chili023/uaefi2stroke/moto/uaefi-moto-pinout.xlsx

Sheet: Anleitung
uaEFI moto – Signal- und Pinbelegung
So bearbeitest du die Belegung:
1. Im Blatt "Signale" nur die gelben Spalten ändern: Stecker (A, B, EGT oder leer), Pin, Kabelfarbe, Querschnitt.
2. Die Blätter "Stecker A", "Stecker B" und "EGT" zeigen automatisch, was auf jedem Pin liegt, inkl. freier und doppelt belegter Pins.
3. Das Blatt "Prüfung" zeigt je Gruppe, ob die Regeln eingehalten sind (rot = Problem).
4. Neue Signale: einfach unten im Blatt "Signale" eine Zeile anhängen (bis Zeile 150 wird alles ausgewertet).
5. Zum Verkabeln die Blätter "Stecker A", "Stecker B" und "EGT" ausdrucken: Pin, Signal, Kabelfarbe, Querschnitt in Pin-Reihenfolge.
Regeln:
• Eine Gruppe (z. B. Lambda 1, alle Einspritzdüsen, VR) liegt komplett auf einem Stecker.
• Versorgung 12V, 5V Sensorversorgung und Sensormasse müssen auf beiden Steckern A und B vorkommen.
• Masse (Leistungsmasse, USB-Masse, VR-Schirm) darf auf beiden liegen.
• Jeder Pin höchstens einmal. Stecker A und B haben je 34 Pins, der EGT-Block 8 (4 Buchsen × 2).
Stecker:
A = TE Superseal 1.0 Header 6437288-1 (Keying 1), Gegenstecker 4-1437290-0
B = TE Superseal 1.0 Header 6437288-2 (Keying 2), Gegenstecker 4-1437290-1
EGT = 4× Omega PCC-SMP-K Mini-Thermoelementbuchse Typ K
Kontakte: alle gleich 1,0 mm, bis 15 A laut TE-Katalog, Kabel 0,5–1,25 mm² (Kontakt 3-1447221-4 bzw. -3)
Quelle Netz/MCU: Netzliste des uaEFI-moto-Schaltplans (chili023/uaefi2stroke, Branch uaefi-moto).
Eingetragen: Stecker A = Basis (alles mit 1: INJ/IGN/GPPWM 1-2, TPS1, CLT, IAT, Hall 1, Lambda 1, USB, CAN), Stecker B = Rest. INJ/IGN 5-6 unbenutzt.
Strom max: Richtwerte (Einspritzdüse/GPPWM-Ausgang bis 3 A, LSU-4.9-Heizung kalt kurz bis 2 A).
Bestückung, die von der uaEFI abweicht:
• Radsensor 2 (B28, PA6): R39 = 4,7k Pull-up auf 5V bestücken, R36 (10k nach Masse) weglassen. Für Hall-Radsensoren; induktive Sensoren gehen dort nicht.
• Radsensor 1 (B20, PE14) hat den 4,7k Pull-up schon.
• Einspritzung/Zündung 5–6 sind auf der Platine vorhanden, aber nicht auf den Steckern.

Sheet: Signale
Gruppe | Signal | Netz (Schaltplan) | MCU / rusEFI | Typ | Strom max | Stecker | Pin | Bemerkung | Schlüssel | Status | Kabelfarbe | Querschnitt mm²
Versorgung 12V | +12V Batterie / ECU-Versorgung | +12V | - | Versorgung | 2 A | A | 1 | über F2 auf +12V_RAW |  |  |  | 0.75
Versorgung 12V | Zündung (Schlüssel) | /12V_KEY | MM100_IN_VBATT (PA5 über Teiler) | Eingang | 0,1 A | A | 2 | ohne Main-Relais identisch mit +12V |  |  |  | 0.50
Versorgung 12V | +12V Hallsensoren (A) | /12V_HALL | - | Versorgung | 0,2 A | A | 3 | PTC F11 200 mA, gleiches Netz wie B1 |  |  |  | 0.75
5V Sensorversorgung | +5V Sensor (A1) | +5VP | - | Versorgung | 0,1 A | A | 4 | geschützte 5V |  |  |  | 0.50
5V Sensorversorgung | +5V Sensor (A2) | +5VP | - | Versorgung | 0,1 A | A | 5 |  |  |  |  | 0.50
Sensormasse | Sensormasse (A1) | GNDA | - | Masse | 0,1 A | A | 6 |  |  |  |  | 0.50
Sensormasse | Sensormasse (A2) | GNDA | - | Masse | 0,1 A | A | 7 |  |  |  |  | 0.50
Masse | Leistungsmasse (A1) | GND | - | Masse | 10 A | A | 8 |  |  |  |  | 0.75
Masse | Leistungsmasse (A2) | GND | - | Masse | 10 A | A | 9 |  |  |  |  | 0.75
Masse | Leistungsmasse (A3) | GND | - | Masse | 10 A | A | 10 |  |  |  |  | 0.75
Einspritzung 1-2 | Einspritzdüse 1 | /OUT_INJ1 | MM100_INJ1 (PD3) | Low-Side | 3 A | A | 11 |  |  |  |  | 0.75
Einspritzung 1-2 | Einspritzdüse 2 | /OUT_INJ2 | MM100_INJ2 (PA9) | Low-Side | 3 A | A | 12 |  |  |  |  | 0.75
Einspritzung 3-4 | Einspritzdüse 3 | /OUT_INJ3 | MM100_INJ3 (PD11) | Low-Side | 3 A | B | 5 |  |  |  |  | 0.75
Einspritzung 3-4 | Einspritzdüse 4 | /OUT_INJ4 | MM100_INJ4 (PD10) | Low-Side | 3 A | B | 6 |  |  |  |  | 0.75
Einspritzung 5-6 (unbenutzt) | Einspritzdüse 5 | /OUT_INJ5 | MM100_INJ5 (PD2) | Low-Side | 3 A
Einspritzung 5-6 (unbenutzt) | Einspritzdüse 6 | /OUT_INJ6 | MM100_INJ6 (PA8) | Low-Side | 3 A
Zündung 1-2 | Zündspule 1 | /OUT_IGN1 | MM100_IGN1 (PC13) | Logik 5V | 0,02 A | A | 13 | für Spulen mit eingebauter Endstufe |  |  |  | 0.50
Zündung 1-2 | Zündspule 2 | /OUT_IGN2 | MM100_IGN2 (PE5) | Logik 5V | 0,02 A | A | 14 | für Spulen mit eingebauter Endstufe |  |  |  | 0.50
Zündung 3-4 | Zündspule 3 | /OUT_IGN3 | MM100_IGN3 (PE4) | Logik 5V | 0,02 A | B | 7 | für Spulen mit eingebauter Endstufe |  |  |  | 0.50
Zündung 3-4 | Zündspule 4 | /OUT_IGN4 | MM100_IGN4 (PE3) | Logik 5V | 0,02 A | B | 8 | für Spulen mit eingebauter Endstufe |  |  |  | 0.50
Zündung 5-6 (unbenutzt) | Zündspule 5 | /OUT_IGN5 | MM100_IGN5 (PE2) | Logik 5V | 0,02 A |  |  | für Spulen mit eingebauter Endstufe
Zündung 5-6 (unbenutzt) | Zündspule 6 | /OUT_IGN6 | MM100_IGN6 (PB8) | Logik 5V | 0,02 A |  |  | für Spulen mit eingebauter Endstufe
GPPWM 1-2 | GPPWM1 | /OUT_LS1 | MM100_INJ7 (PD15) | Low-Side | 3 A | A | 15 | mit Freilaufdiode |  |  |  | 0.75
GPPWM 1-2 | GPPWM2 | /OUT_LS2 | MM100_INJ8 (PD12) | Low-Side | 3 A | A | 16 | mit Freilaufdiode |  |  |  | 0.75
GPPWM 3-4 | GPPWM3 | /OUT_LS3 | MM100_OUT_PWM1 (PD13) | Low-Side | 3 A | B | 9 | mit Freilaufdiode |  |  |  | 0.75
GPPWM 3-4 | GPPWM4 | /OUT_LS4 | MM100_OUT_PWM2 (PC6) | Low-Side | 3 A | B | 10 | mit Freilaufdiode |  |  |  | 0.75
Basis-Sensoren | TPS1 | /IN_TPS1 | MM100_IN_TPS (PA4) | Analog 0–5V | - | A | 17 |  |  |  |  | 0.50
Basis-Sensoren | CLT | /IN_CLT | MM100_IN_CLT (PC2) | Analog 0–5V | - | A | 18 |  |  |  |  | 0.50
Basis-Sensoren | IAT | /IN_IAT | MM100_IN_IAT (PC3) | Analog 0–5V | - | A | 19 |  |  |  |  | 0.50
Hall 1 | Hall 1 (Kurbelwelle) | /IN_HALL1 | MM100_IN_D1 (PE12) | Digital | - | A | 20 | 4,7k Pull-up, Trigger in Firmware |  |  |  | 0.50
Lambda 1 | Lambda 1 Heizung + (LSU Pin 4) | +12V_RAW | Modul M5 | Lambda | 2 A | A | 21 | kalt kurz bis 2 A |  |  |  | 0.75
Lambda 1 | Lambda 1 Heizung − (LSU Pin 3) | /3_WBO_Heater | Modul M5 | Lambda | 2 A | A | 22 | kalt kurz bis 2 A |  |  |  | 0.75
Lambda 1 | Lambda 1 Ip (LSU Pin 1) | /1_WBO_Ip | Modul M5 | Lambda | 0,01 A | A | 23 |  |  |  |  | 0.50
Lambda 1 | Lambda 1 Vm (LSU Pin 2) | /2_WBO_Vm | Modul M5 | Lambda | 0,01 A | A | 24 |  |  |  |  | 0.50
Lambda 1 | Lambda 1 Un (LSU Pin 6) | /6_WBO_Un | Modul M5 | Lambda | 0,01 A | A | 25 |  |  |  |  | 0.50
Lambda 1 | Lambda 1 Rtrim (LSU Pin 5) | /5_WBO_Rtrim | Modul M5 | Lambda | 0,01 A | A | 26 |  |  |  |  | 0.50
Lambda 2 | Lambda 2 Heizung + (LSU Pin 4) | +12V_RAW | Modul M8 | Lambda | 2 A | B | 29 | kalt kurz bis 2 A |  |  |  | 0.75
Lambda 2 | Lambda 2 Heizung − (LSU Pin 3) | /WBO2_Heater | Modul M8 | Lambda | 2 A | B | 30 | kalt kurz bis 2 A |  |  |  | 0.75
Lambda 2 | Lambda 2 Ip (LSU Pin 1) | /WBO2_Ip | Modul M8 | Lambda | 0,01 A | B | 31 |  |  |  |  | 0.50
Lambda 2 | Lambda 2 Vm (LSU Pin 2) | /WBO2_Vm | Modul M8 | Lambda | 0,01 A | B | 32 |  |  |  |  | 0.50
Lambda 2 | Lambda 2 Un (LSU Pin 6) | /WBO2_Un | Modul M8 | Lambda | 0,01 A | B | 33 |  |  |  |  | 0.50
Lambda 2 | Lambda 2 Rtrim (LSU Pin 5) | /WBO2_Rtrim | Modul M8 | Lambda | 0,01 A | B | 34 |  |  |  |  | 0.50
USB | USB VBUS | /VBUS | VBUS (N1) | USB | 0,1 A | A | 27 | USB-Erkennung |  |  |  | 0.50
USB | USB D+ | /USB+ | PA12 | USB | - | A | 28 | verdrillt mit D− |  |  |  | 0.50
USB | USB D− | /USB- | PA11 | USB | - | A | 29 |  |  |  |  | 0.50
USB | USB Masse | GND | - | Masse | - | A | 30 |  |  |  |  | 0.50
CAN | CAN High | /CAN+ | CAN-Modul M7 | CAN | - | A | 31 | intern auch Lambda-Module |  |  |  | 0.50
CAN | CAN Low | /CAN- | CAN-Modul M7 | CAN | - | A | 32 |  |  |  |  | 0.50
Versorgung 12V | +12V Hallsensoren (B) | /12V_HALL | - | Versorgung | 0,2 A | B | 1 | gleiches Netz wie A3 |  |  |  | 0.75
5V Sensorversorgung | +5V Sensor (B) | +5VP | - | Versorgung | 0,1 A | B | 2 |  |  |  |  | 0.50
Sensormasse | Sensormasse (B) | GNDA | - | Masse | 0,1 A | B | 3 |  |  |  |  | 0.50
Masse | Leistungsmasse (B) | GND | - | Masse | 10 A | B | 4 | Rückstrom INJ/IGN/GPPWM 3-4, Lambda-2-Heizung |  |  |  | 0.75
Relais-Ausgang 1 | schwacher Low-Side 1 | /OUT_LS_HOT1 | MM100_IGN7 (PB9) | Low-Side | 0,5 A | A | 33 | nur Relais, keine Freilaufdiode |  |  |  | 0.75
Relais-Ausgang 2 | schwacher Low-Side 2 | /OUT_LS_HOT2 | MM100_IGN8 (PE6) | Low-Side | 0,5 A | B | 12 | nur Relais, keine Freilaufdiode |  |  |  | 0.75
Zusatz-Sensoren | TPS2 | /IN_TPS2 | MM100_IN_AUX1 (PB0) | Analog 0–5V | - | B | 13 |  |  |  |  | 0.50
Zusatz-Sensoren | MAP | /IN_MAP | MM100_IN_MAP1 (PC0) | Analog 0–5V | - | B | 14 | Baro kommt vom MAP-Sensor auf der Platine |  |  |  | 0.50
Analog-Eingänge | Analog 1 | /IN_AUX1 | MM100_IN_O2S (PA0) | Analog 0–5V | - | B | 15 |  |  |  |  | 0.50
Analog-Eingänge | Analog 2 | /IN_AUX2 | MM100_IN_O2S2 (PA1) | Analog 0–5V | - | B | 16 |  |  |  |  | 0.50
Analog-Eingänge | Analog 3 | /IN_PPS1 | MM100_IN_PPS (PA3) | Analog 0–5V | - | B | 17 |  |  |  |  | 0.50
Analog-Eingänge | Analog 4 | /IN_PPS2 | MM100_IN_AUX2 (PC4) | Analog 0–5V | - | B | 18 |  |  |  |  | 0.50
Analog-Eingänge | Analog 5 | /IN_AUX3 | MM100_IN_AUX3 (PA7) | Analog 0–5V | - | B | 11 |  |  |  |  | 0.50
Hall 2-3 | Hall 2 | /IN_HALL2 | MM100_IN_D2 (PE13) | Digital | - | B | 19 | 4,7k Pull-up |  |  |  | 0.50
Hall 2-3 | Hall 3 / Radsensor 1 (VSS) | /IN_HALL3 | MM100_IN_D3 (PE14) | Digital | - | B | 20 | 4,7k Pull-up, in Firmware als VSS |  |  |  | 0.50
Digital-Eingänge | Flex | /IN_FLEX | MM100_IN_VSS (PE11) | Digital | - | B | 21 | 10k Pull-up |  |  |  | 0.50
Digital-Eingänge | Schalteingang 1 | /IN_BUTTON1 | MM100_IN_CRANK (PB1) | Digital | - | B | 22 |  |  |  |  | 0.50
Digital-Eingänge | Radsensor 2 (Schalteingang 2) | /IN_BUTTON2 | MM100_IN_CAM (PA6) | Digital | - | B | 28 | für Hall-Radsensor R39 als Pull-up bestücken, R36 weglassen |  |  |  | 0.50
Reserve Eingänge | Schalteingang 3 | /IN_BUTTON3 | MM100_IN_D4 (PE15) | Digital | - |  |  | kein Platz mehr
VR | VR1 + (diskret) | /VR_DISCRETE+ | UART8_RX (PE0) | VR | - | B | 23 |  |  |  |  | 0.50
VR | VR1 − (diskret) | /VR_DISCRETE- | - | VR | - | B | 24 |  |  |  |  | 0.50
VR | VR2 + (MAX9924) | /VR_MAX9924+ | UART8_TX (PE1) | VR | - | B | 25 |  |  |  |  | 0.50
VR | VR2 − (MAX9924) | /VR_MAX9924- | - | VR | - | B | 26 |  |  |  |  | 0.50
VR | VR Schirm | GND | - | Masse | - | B | 27 |  |  |  |  | 0.50
Klopfsensor | Klopfsensor | /IN_KNOCK_RAW | Klopfmodul M2 → PA2 | Analog | - | A | 34 | Schirm auf Sensormasse |  |  |  | 0.50
EGT1 | EGT1 + (Chromel) | /EGT+ | MAX31855, CS PA15 | Thermoelement Typ K | - | EGT | 1 | Mini-Buchse PCC-SMP-K
EGT1 | EGT1 − (Alumel) | /EGT- | MAX31855, CS PA15 | Thermoelement Typ K | - | EGT | 2
EGT2 | EGT2 + (Chromel) | /EGT2+ | MAX31855, CS PC7 | Thermoelement Typ K | - | EGT | 3 | Mini-Buchse PCC-SMP-K
EGT2 | EGT2 − (Alumel) | /EGT2- | MAX31855, CS PC7 | Thermoelement Typ K | - | EGT | 4
EGT3 | EGT3 + (Chromel) | /EGT3+ | MAX31855, CS PC8 | Thermoelement Typ K | - | EGT | 5 | Mini-Buchse PCC-SMP-K
EGT3 | EGT3 − (Alumel) | /EGT3- | MAX31855, CS PC8 | Thermoelement Typ K | - | EGT | 6
EGT4 | EGT4 + (Chromel) | /EGT4+ | MAX31855, CS PC9 | Thermoelement Typ K | - | EGT | 7 | Mini-Buchse PCC-SMP-K
EGT4 | EGT4 − (Alumel) | /EGT4- | MAX31855, CS PC9 | Thermoelement Typ K | - | EGT | 8
Reserve MCU | freier MCU-Pin PB14 | /DC1_DIS | PB14 | GPIO | - |  |  | war E-Gas-Treiber, jetzt frei
Reserve MCU | freier MCU-Pin PB15 | /DC2_DIR | PB15 | GPIO | - |  |  | war E-Gas-Treiber, jetzt frei
Reserve MCU | freier MCU-Pin PA10 | /DC2_DIS | PA10 | GPIO | - |  |  | war E-Gas-Treiber, jetzt frei

Sheet: Prüfung
Gruppe | Regel | Signale | auf A | auf B | auf EGT | nicht belegt | Ergebnis
Versorgung 12V | auf A und B
5V Sensorversorgung | auf A und B
Sensormasse | auf A und B
Masse | beliebig
Einspritzung 1-2 | ein Stecker
Einspritzung 3-4 | ein Stecker
Einspritzung 5-6 (unbenutzt) | beliebig
Zündung 1-2 | ein Stecker
Zündung 3-4 | ein Stecker
Zündung 5-6 (unbenutzt) | beliebig
GPPWM 1-2 | ein Stecker
GPPWM 3-4 | ein Stecker
Basis-Sensoren | ein Stecker
Hall 1 | ein Stecker
Lambda 1 | ein Stecker
Lambda 2 | ein Stecker
USB | ein Stecker
CAN | ein Stecker
Relais-Ausgang 1 | ein Stecker
Relais-Ausgang 2 | ein Stecker
Zusatz-Sensoren | ein Stecker
Analog-Eingänge | ein Stecker
Hall 2-3 | ein Stecker
Digital-Eingänge | ein Stecker
Reserve Eingänge | beliebig
VR | ein Stecker
Klopfsensor | ein Stecker
EGT1 | ein Stecker
EGT2 | ein Stecker
EGT3 | ein Stecker
EGT4 | ein Stecker
Reserve MCU | beliebig
Belegte Pins
Doppelt belegte Signale
Regelverstöße Gruppen

Sheet: Stecker A
Pin | Signal | Gruppe | Netz | Typ | Strom max | Belegung | Kabelfarbe | Querschnitt mm²
1
2
3
4
5
6
7
8
9
10
11
12
13
14
15
16
17
18
19
20
21
22
23
24
25
26
27
28
29
30
31
32
33
34
Belegt
Frei

Sheet: Stecker B
Pin | Signal | Gruppe | Netz | Typ | Strom max | Belegung | Kabelfarbe | Querschnitt mm²
1
2
3
4
5
6
7
8
9
10
11
12
13
14
15
16
17
18
19
20
21
22
23
24
25
26
27
28
29
30
31
32
33
34
Belegt
Frei

Sheet: EGT
Pin | Signal | Gruppe | Netz | Typ | Strom max | Belegung | Kabelfarbe | Querschnitt mm²
1
2
3
4
5
6
7
8
Belegt
Frei

Sheet: Teile
Position | Teil | Hersteller | Artikelnummer | Menge je ECU | Bemerkung
Stecker A (J30) | Superseal 1.0 Header 34-pol., 90°, Keying 1 | TE Connectivity | 6437288-1 | 1 | auf der Platine
Stecker A Gegenstecker | Superseal 1.0 Buchsengehäuse 34-pol., Keying 1 | TE Connectivity | 4-1437290-0 | 1 | Kabelbaum
Stecker B (J31) | Superseal 1.0 Header 34-pol., 90°, Keying 2 | TE Connectivity | 6437288-2 | 1 | auf der Platine
Stecker B Gegenstecker | Superseal 1.0 Buchsengehäuse 34-pol., Keying 2 | TE Connectivity | 4-1437290-1 | 1 | Kabelbaum
Kontakt 0,5 mm² | Superseal 1.0 Buchsenkontakt | TE Connectivity | 3-1447221-4 |  | Menge aus Blatt Signale (Querschnitt 0,5)
Kontakt 0,75–1,25 mm² | Superseal 1.0 Buchsenkontakt | TE Connectivity | 3-1447221-3 |  | Menge aus Blatt Signale (Querschnitt > 0,5)
Blindstopfen | Superseal 1.0 Blindstopfen weiß | TE Connectivity | 4-1437284-3 |  | für unbelegte Kammern
Crimpzange | CERTI-CRIMP Handzange 1,0 mm Kontakte | TE Connectivity | 1454509-1 |  | Werkzeug
EGT-Buchse (J32–J35) | Mini-Thermoelementbuchse Typ K, Leiterplatte | Omega | PCC-SMP-K | 4 | auf der Platine
EGT-Stecker | Mini-Thermoelementstecker Typ K | Omega | SMPW-K-M | 4 | am Fühler, meist schon dran
Bluetooth (U5) | JDY-33 Modul | HuiCheng | LCSC C9900001612 | 1 | bestückt, mit C40/C41 gegen Einschaltproblem
Quelle Artikelnummern: TE Superseal 1.0 Katalog (1308072-2), Omega Datenblatt PCC-SMP.
