chili023/uaefi2stroke/uaefi.kicad_pcb

## KiCad design uaefi.kicad_pcb (2026-09-23)

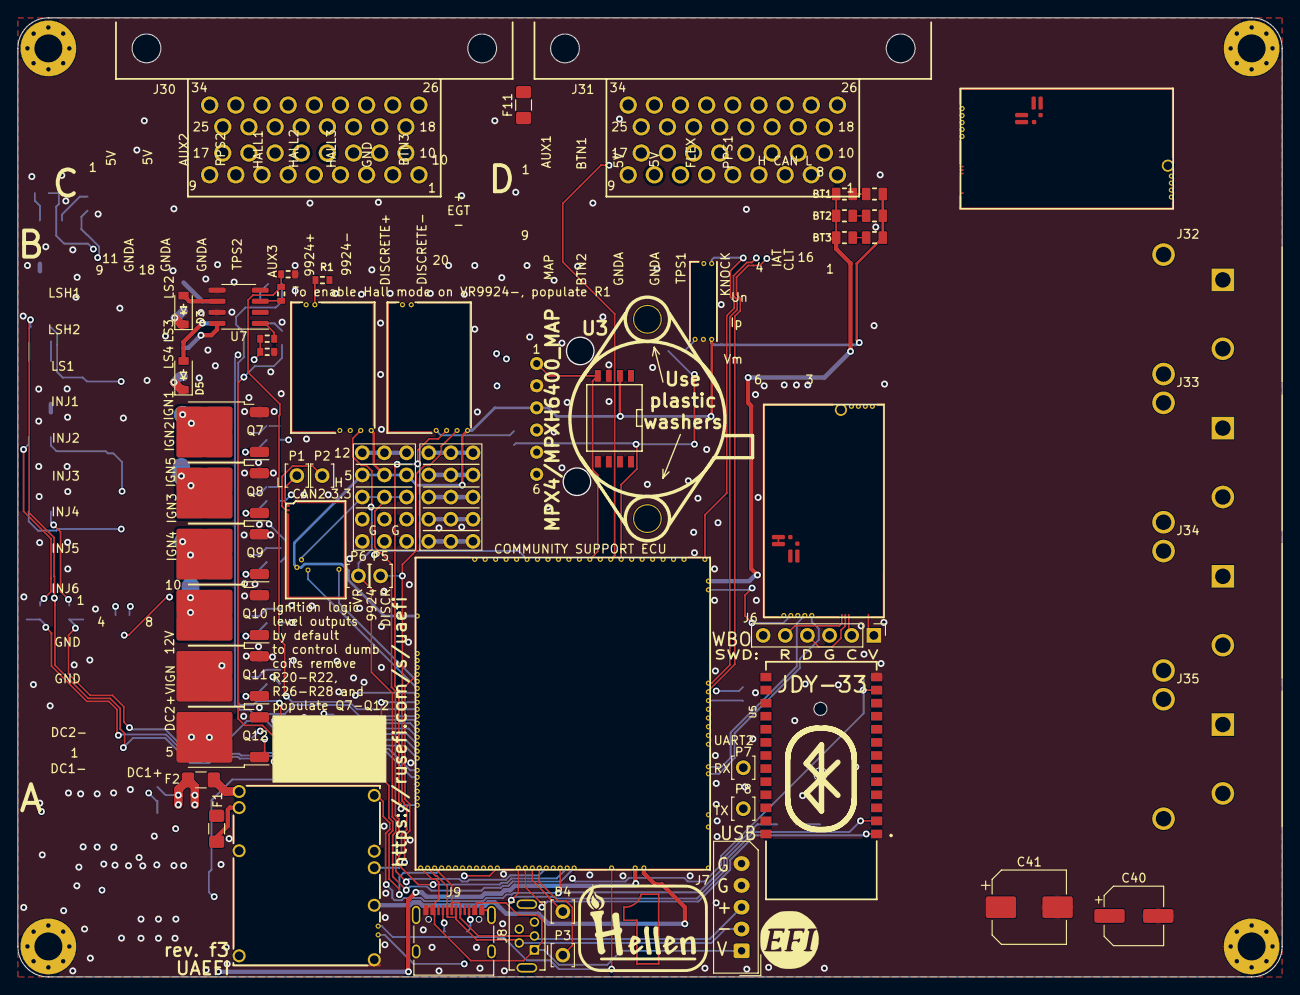
[picture p1: board uaefi.kicad_pcb from above]

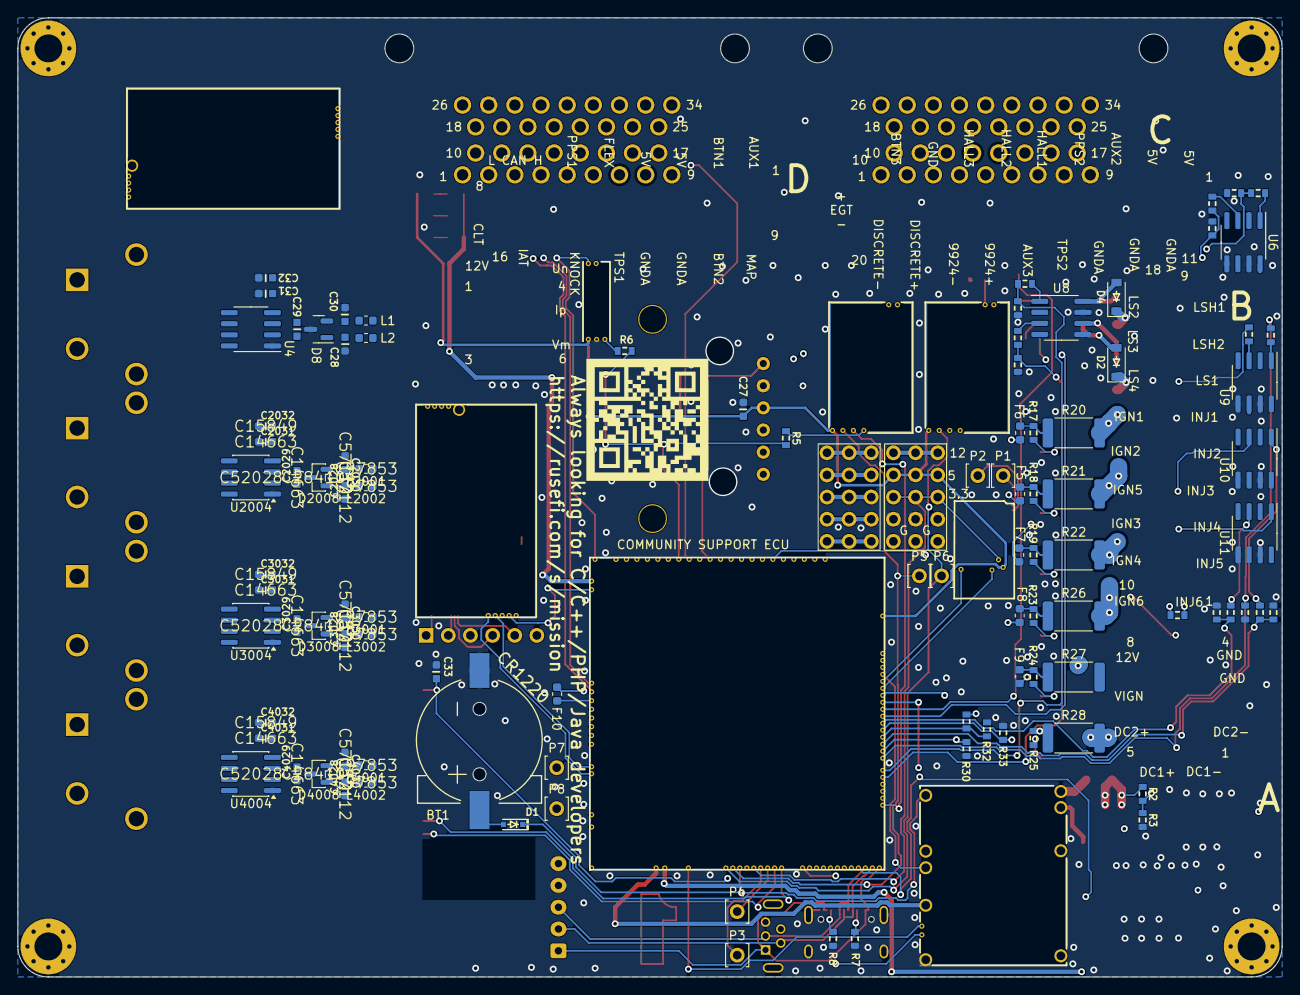
[picture p2: board uaefi.kicad_pcb from below]

Board: 4 copper layers, 145.0 x 110.0 mm, 152 parts (91 on the bottom side), 163 nets.

Parts:
BT1: CR1220; CR1220-2
C27, C29, C31, C33, C2029, C2031, C3029, C3031, C4029, C4031: 100n; C0603
C28, C30, C2028, C2030, C3028, C3030, C4028, C4030: 10n; C0603
C32, C2032, C3032, C4032: 1u; C0603
C40: 47uF 16V; CP_Elec_6.3x5.4
C41: 470uF 6.3V; CP_Elec_8x10
D1: 1N4148WS; SOD-323
D2, D3, D4, D5: B5819W; SOD-123
D8, D2008, D3008, D4008: NUP2105L; SOT-23
F1, F2: Fuse; Fuse_1206_3216Metric_Pad1.42x1.75mm_HandSolder
F5, F6, F7, F8, F9, F10: 50mA; Fuse_0603_1608Metric
F11: PTC 200mA hold; Fuse_1206_3216Metric_Pad1.42x1.75mm_HandSolder
G1: RUSEFI_LOGO; rusefi_logo
G2: LOGO
G3, G4: PROTO_AREA
H1, H2, H3, H4: M3; MountingHole_3.2mm_M3_Pad_Via
J6: Conn_01x06; PinHeader_1x06_P2.54mm_Vertical
J7: Conn_01x05_Male; Molex_SPOX_5267-05A_1x05_P2.50mm_Vertical
J8: USB_B_Mini; USB-MINI-B-VERTICAL
J9: USB_C
J30: TE 6437288-1 (A, keying 1); 6437288-2
J31: TE 6437288-2 (B, keying 2); 6437288-2
J32: EGT1 PCC-SMP-K; Omega_PCC-SMP-K
J33: EGT2 PCC-SMP-K; Omega_PCC-SMP-K
J34: EGT3 PCC-SMP-K; Omega_PCC-SMP-K
J35: EGT4 PCC-SMP-K; Omega_PCC-SMP-K
L1, L2, L2001, L2002, L3001, L3002, L4001, L4002: 470R@100MHz; L_0603_1608Metric
M1: Module-power_12and5V-0.3; power_12and5V
M2: Module-knock-0.2; knock
M3: Module-vr-discrete-0.5; vr-discrete
M4: Module-vr-max9924-0.1; vr-max9924
M5, M8: Module-wbo-0.6; wbo
M6: Module:mega-mcu100/0.3; mega-mcu100
M7: Module-can-0.1; can
P1, P2, P3, P4, P5, P6, P7, P8: Pad; PAD-TH
Q7, Q8, Q9, Q10, Q11, Q12: ISL9V3040D3ST; TO-252-2
R1, R4, R10, R11, R12, R13, R15, R16, R29, R30, R31, R32, R33, R34, R41, R42, R43, R44, R45, R46, R47, R48, R49, R50, R51: 4.7k; R0603
R2: 33k; R0603
R3: 6.8k; R0603
R5, R6: 0; R0603
R7, R8: 5.6k; R0603
R17, R18, R19, R23, R24, R25: 22; R0603
R20, R21, R22, R26, R27, R28: 0; R_2512_6332Metric
R35, R36, R37: 10k; R0805
R38, R40: DNP; R0805
R39: 4.7k; R0805
U3: MPX4/MPXH6400_MAP; MPX-4_MAP
U4, U2004, U3004, U4004: MAX31855KASA; SOIC-8_3.9x4.9mm_P1.27mm
U5: JDY-33
U6, U7, U8, U9, U10, U11: VNLD5160TR-E; SOIC-8_3.9x4.9mm_P1.27mm

Connections:
+3.3VA: C31.2, C32.2, C33.2, C41.1, C2031.2, C2032.2, C3031.2, C3032.2, C4031.2, C4032.2, G3.3, G3.8, G3.13, M6.N15 (V33_SWITCHABLE), M7.V2 (CAN_VIO), U4.4 (V_{CC}), U5.12 (3V3), U2004.4, U3004.4, U4004.4
+5V: C40.1, M1.E4 (V5), M6.N22 (VCC)
+5VA: C27.2, G3.4, G3.9, G3.14, M2.E1 (V5A), M3.E4 (V5_IN), M4.E4 (V5_IN), M5.W1 (V5_IN), M6.E1 (V5A_SWITCHABLE), M6.W2 (V5A_SWITCHABLE), M7.V1 (V5), M8.W1, R38.2, R39.2, R40.2, U3.3 (VCC)
+5VP: J30.4, J30.5, J31.2, M1.V4 (5VP), R1.1
+12V: F2.1, J30.1, R2.2
+12V_RAW: D2.1 (K), D3.1 (K), D4.1 (K), D5.1 (K), F2.2, F11.1, G3.5, G3.10, G3.15, J30.21, J31.29, M1.V1 (V12_PERM), M1.V3 (V12_RAW)
/1_WBO_Ip: J30.23, M5.E3 (LSU_Ip)
/2_WBO_Vm: J30.24, M5.E2 (LSU_Vm)
/3_WBO_Heater: J30.22, M5.E5 (LSU_Htr)
/5_WBO_Rtrim: J30.26, M5.E4 (LSU_Rtrim)
/6_WBO_Un: J30.25, M5.E1 (LSU_Un)
/12V_HALL: F11.2, J30.3, J31.1
/12V_KEY: F1.1, J30.2
/ADC3: M6.S15 (IN_KNOCK_(PA2)), R5.2, R6.2
/CAN+: J30.31, M5.W4 (CANH), M6.W11 (CANH), M8.W4
/CAN-: J30.32, M5.W3 (CANL), M6.W12 (CANL), M8.W3
/DC1_DIR: M6.E21 (OUT_PWM4_(PC8)), U3004.6
/DC1_PWM: M6.E20 (OUT_PWM3_(PC7)), U2004.6
/DC2_PWM: M6.E22 (OUT_PWM5_(PC9)), U4004.6
/EGT2+: J33.1, L2001.1
/EGT2-: J33.2, L2002.1
/EGT3+: J34.1, L3001.1
/EGT3-: J34.2, L3002.1
/EGT4+: J35.1, L4001.1
/EGT4-: J35.2, L4002.1
/EGT+: J32.1, L1.1
/EGT-: J32.2, L2.1
/EGT/SPI_CS: M6.N9 (SPI3_CS_(PA15)), U4.6 (~CS)
/IGN1: F6.2, M6.W10 (IGN1_(PC13))
/IGN2: F5.2, M6.W9 (IGN2_(PE5))
/IGN3: F7.2, M6.W8 (IGN3_(PE4))
/IGN4: F8.2, M6.W7 (IGN4_(PE3))
/IGN5: F9.2, M6.W6 (IGN5_(PE2))
/IGN6: F10.2, M6.W5 (IGN6_(PB8))
/INJ1: M6.E17 (OUT_INJ1_(PD3)), R29.2, R42.1
/INJ2: M6.E16 (OUT_INJ2_(PA9)), R30.2, R43.1
/INJ3: M6.E15 (OUT_INJ3_(PD11)), R31.2, R44.1
/INJ4: M6.E14 (OUT_INJ4_(PD10)), R32.2, R45.1
/INJ5: M6.E13 (OUT_INJ5_(PD2)), R33.2, R46.1
/INJ6: M6.E12 (OUT_INJ6_(PA8)), R34.2, R47.1
/INTERNAL_MAP: M6.S12 (IN_MAP2_(PC1)), U3.1 (VOUT)
/IN_AUX1: J31.15, M6.S11 (IN_O2S_/_CAN_WAKEUP_(PA0))
/IN_AUX2: J31.16, M6.S10 (IN_O2S2_(PA1))
/IN_AUX3: J31.11, M6.S7 (IN_AUX3_(PA7))
/IN_BUTTON1: J31.22, M6.S14 (IN_CRANK_(PB1)), R35.2, R38.1
/IN_BUTTON2: J31.28, M6.S16 (IN_CAM_(PA6)), R36.2, R39.1
/IN_BUTTON3: M6.S1 (IN_D4_(PE15)), R37.2, R40.1
/IN_CLT: J30.18, M6.S21 (IN_CLT_(PC2))
/IN_FLEX: J31.21, M6.S17 (IN_VSS_(PE11))
/IN_HALL1: J30.20, M6.S4 (IN_D1_(PE12))
/IN_HALL2: J31.19, M6.S3 (IN_D2_(PE13))
/IN_HALL3: J31.20, M6.S2 (IN_D3_(PE14))
/IN_IAT: J30.19, M6.S20 (IN_IAT_(PC3))
/IN_KNOCK: M2.E3 (OUT_KNOCK), R6.1
/IN_KNOCK_RAW: J30.34, M2.W1 (IN_KNOCK)
/IN_MAP: J31.14, M6.S13 (IN_MAP1_(PC0))
/IN_PPS1: J31.17, M6.S19 (IN_PPS_(PA3))
/IN_PPS2: J31.18, M6.S8 (IN_AUX2_(PC4/PE9))
/IN_TPS1: J30.17, M6.S18 (IN_TPS_(PA4))
/IN_TPS2: J31.13, M6.S9 (IN_AUX1_(PB0))
/IN_VIGN: F1.2, M1.V2 (IN_VIGN)
/IN_VMAIN: M6.S6 (IN_AUX4_(PC5)), R2.1, R3.2
/Ignition/OUT5: Q11.2 (C), R27.2
/Ignition/OUT6: Q12.2 (C), R28.2
/LS1: M6.E11 (OUT_INJ7_(PD15)), R10.2, R48.1
/LS2: M6.E10 (OUT_INJ8_(PD12)), R11.2, R49.1
/LS3: M6.E18 (OUT_PWM1_(PD13)), R12.2, R50.1
/LS4: M6.E19 (OUT_PWM2_(PC6)), R13.2, R51.1
/LS_HOT1: M6.W4 (IGN7_(PB9)), R16.1, R41.1
/LS_HOT2: M6.W3 (IGN8_(PE6)), R4.1, R15.1
/MISO3: M6.N11 (SPI3_MISO_(PC11)), U4.7 (SO), U2004.7, U3004.7, U4004.7
/OUT_IGN1: J30.13, Q7.2 (C), R20.2
/OUT_IGN2: J30.14, Q8.2 (C), R21.2
/OUT_IGN3: J31.7, Q9.2 (C), R22.2
/OUT_IGN4: J31.8, Q10.2 (C), R26.2
/OUT_INJ1: J30.11, U9.8 (D1)
/OUT_INJ2: J30.12, U9.6 (D2)
/OUT_INJ3: J31.5, U10.8 (D1)
/OUT_INJ4: J31.6, U10.6 (D2)
/OUT_LS1: D2.2 (A), J30.15, U7.8 (D1)
/OUT_LS2: D3.2 (A), J30.16, U7.6 (D2)
/OUT_LS3: D4.2 (A), J31.9, U8.8 (D1)
/OUT_LS4: D5.2 (A), J31.10, U8.6 (D2)
/OUT_LS_HOT1: J30.33, U6.6 (D2)
/OUT_LS_HOT2: J31.12, U6.8 (D1)
/PG_5VP: M1.E6 (PG_5VP), M6.N12 (SPI3_MOSI_(PC12))
/PWR_EN: M1.E5 (EN_5VP), M6.N20 (OUT_PWR_EN_(PE10))
/SCK3: M6.N10 (SPI3_SCK_(PC10)), U4.5 (SCK), U2004.5, U3004.5, U4004.5
/USB+: J7.3, J8.3 (D+), J9.A6 (D+), J9.B6 (D+), J30.28, M6.N3 (USBP_(PA12))
/USB-: J7.2, J8.2 (D-), J9.A7 (D-), J9.B7 (D-), J30.29, M6.N2 (USBM_(PA11))
/VBAT: D1.1 (K), M1.E1 (VBAT), M6.N17 (VBAT)
/VBUS: J7.1, J8.1 (VBUS), J9.A4 (VBUS), J9.A9 (VBUS), J9.B4 (VBUS), J9.B9 (VBUS), J30.27, M6.N1 (VBUS)
/VIGN: M1.E3 (VIGN), M6.E5 (IN_VIGN_(PA5))
/VREF1: M2.W2 (VREF), M6.S22 (VREF1)
/VR_DISCRETE: M3.E3 (OUT), M6.N18 (UART8_RX_(PE0)), P5.1
/VR_DISCRETE+: J31.23, M3.W2 (VR+)
/VR_DISCRETE-: J31.24, M3.W1 (VR-)
/VR_DISCRETE_A: M3.E2 (OUT_A), R5.1
/VR_DISCRETE_THR: M3.E1 (Thresh_IN), M6.E23 (OUT_PWM6_(PD14))
/VR_MAX9924: M4.E3 (OUT), M6.N19 (UART8_TX_(PE1)), P6.1
/VR_MAX9924+: J31.25, M4.W2 (VR+)
/VR_MAX9924-: J31.26, M4.W1 (VR-), R1.2
/WBO2_Heater: J31.30, M8.E5
/WBO2_Ip: J31.31, M8.E3
/WBO2_Rtrim: J31.34, M8.E4
/WBO2_SEL2: M8.J2, M8.J_VCC2
/WBO2_Un: J31.33, M8.E1
/WBO2_Vm: J31.32, M8.E2
GND: BT1.2 (-), C27.1, C28.1, C30.1, C31.1, C32.1, C33.1, C40.2, C41.2, C2028.1, C2030.1, C2031.1, C2032.1, C3028.1, C3030.1, C3031.1, C3032.1, C4028.1, C4030.1, C4031.1, C4032.1, D8.3 (A), D2008.3, D3008.3, D4008.3, G3.1, G3.2, G3.6, G3.7, G3.11, G3.12, J6.3, J7.4, J7.5, J8.5 (GND), J8.6 (Shield), J9.A1 (GND), J9.A12 (GND), J9.B1 (GND), J9.B12 (GND), J9.S1 (SHIELD), J30.8, J30.9, J30.10, J30.30, J31.4, J31.27, M1.S1 (GND), M2.E2 (GND), M3.G (GND), M4.G (GND), M5.G (GND), M6.G (GND), M7.E1 (GND), M8.G, Q7.3 (E), Q8.3 (E), Q9.3 (E), Q10.3 (E), Q11.3 (E), Q12.3 (E), R3.1, R7.1, R8.1, R10.1, R11.1, R12.1, R13.1, R15.2, R16.2, R29.1, R30.1, R31.1, R32.1, R33.1, R34.1, U3.2 (GND), U4.1 (GND), U5.13 (GND), U6.5 (S2), U6.7 (S1), U7.5 (S2), U7.7 (S1), U8.5 (S2), U8.7 (S1), U9.5 (S2), U9.7 (S1), U10.5 (S2), U10.7 (S1), U11.5 (S2), U11.7 (S1), U2004.1, U3004.1, U4004.1
GNDA: J30.6, J30.7, J31.3, M6.W1 (GNDA), R35.1, R36.1, R37.1
unnamed: BT1.1 (+), D1.2 (A)
unnamed: F5.1, R18.2, R21.1
unnamed: F6.1, R17.2, R20.1
unnamed: F7.1, R19.2, R22.1
unnamed: F8.1, R23.2, R26.1
unnamed: F9.1, R24.2, R27.1
unnamed: F10.1, R25.2, R28.1
unnamed: G4.1, G4.6, G4.11
unnamed: G4.5, G4.10, G4.15
unnamed: G4.2, G4.7, G4.12
unnamed: G4.3, G4.8, G4.13
unnamed: G4.4, G4.9, G4.14
unnamed: J6.1, M5.W8 (V33_OUT)
unnamed: J6.2, M5.W7 (SWCLK)
unnamed: J6.4, M5.W6 (SWDIO)
unnamed: J6.5, M5.W5 (nReset)
unnamed: J9.A5 (CC1), R7.2
unnamed: J9.B5 (CC2), R8.2
unnamed: M5.J1 (SEL1), M5.J_GND1 (PULL_DOWN1)
unnamed: M6.N14a (LED_GREEN), P4.1
unnamed: M6.N14b (LED_YELLOW), P3.1
unnamed: M6.E6 (SPI2_CS_/_CAN2_RX_(PB12)), M7.V6 (CAN_RX)
unnamed: M6.E7 (SPI2_SCK_/_CAN2_TX_(PB13)), M7.V5 (CAN_TX)
unnamed: M6.N14 (UART2_RX_(PD6)), P7.1, U5.1 (TXD)
unnamed: M6.N13 (UART2_TX_(PD5)), P8.1, U5.2 (RXD)
unnamed: M7.S2 (CANH), P2.1
unnamed: M7.S1 (CANL), P1.1
unnamed: Q7.1 (G), R17.1
unnamed: Q8.1 (G), R18.1
unnamed: Q9.1 (G), R19.1
unnamed: Q10.1 (G), R23.1
unnamed: Q11.1 (G), R24.1
unnamed: Q12.1 (G), R25.1
unnamed: C29.2, C30.2, D8.2 (K), L1.2, U4.3 (T+)
unnamed: C28.2, C29.1, D8.1 (K), L2.2, U4.2 (T-)
unnamed: R4.2, U6.1 (IN1)
unnamed: R41.2, U6.3 (IN2)
unnamed: R48.2, U7.1 (IN1)
unnamed: R49.2, U7.3 (IN2)
unnamed: R50.2, U8.1 (IN1)
unnamed: R51.2, U8.3 (IN2)
unnamed: R42.2, U9.1 (IN1)
unnamed: R43.2, U9.3 (IN2)
unnamed: R44.2, U10.1 (IN1)
unnamed: R45.2, U10.3 (IN2)
unnamed: R46.2, U11.1 (IN1)
unnamed: R47.2, U11.3 (IN2)
unnamed: C2029.2, C2030.2, D2008.2, L2001.2, U2004.3
unnamed: C2028.2, C2029.1, D2008.1, L2002.2, U2004.2
unnamed: C3029.2, C3030.2, D3008.2, L3001.2, U3004.3
unnamed: C3028.2, C3029.1, D3008.1, L3002.2, U3004.2
unnamed: C4029.2, C4030.2, D4008.2, L4001.2, U4004.3
unnamed: C4028.2, C4029.1, D4008.1, L4002.2, U4004.2
