chili023/uaefi2stroke/(commit log)

2026-09-23 uaefi-moto: PCB change specification
2026-09-23 uaefi-moto schematic: 2x Superseal 34, 4x EGT, second WBO, no DC drivers [skip ci]
    - J2/J3/J4/J5/J10 Mini-Fit replaced by J30 (TE 6437288-1) and J31 (TE 6437288-2)
    - three more EGT sheet instances (CS on DC1_PWM/DC1_DIR/DC2_PWM) + four PCC-SMP-K sockets
    - second Module-wbo-0.6 (M8) strapped to hardware index 5
    - DC Driver sheets and their fuses F3/F4 removed
    - PTC F11 for +12V hall supply
    - ERC: 0 errors; netlist verified against original
    [DC_MOTOR_0.1.kicad_sch, egt.kicad_sch, uaefi.kicad_sch]
2026-09-23 uaefi-moto schematic: tidy new area [skip ci]
    [egt.kicad_sch, uaefi.kicad_sch]
2026-09-23 uaefi-moto: new A/B split from wiring spreadsheet [skip ci]
    - A = base harness (INJ/IGN/GPPWM 1-2, TPS1, CLT, IAT, crank hall, WBO1, USB, CAN, relay 1, knock)
    - B = extension (INJ/IGN/GPPWM 3-4, WBO2, VR, cam hall, wheel sensors, analog, relay 2)
    - INJ/IGN 5-6 not on connectors, IGN6 sheet output no-connect
    - wheel sensor 2 on IN_BUTTON2: R39 4.7k populated, R36 DNP
    - moto/uaefi-moto-pinout.xlsx is the source of truth for the pinout
    - ERC 0 errors, netlist verified against original and against spreadsheet
    [egt.kicad_sch, uaefi-moto-pinout.xlsx, uaefi.kicad_sch]
2026-09-23 uaefi-moto: PCB prepared for routing, bluetooth fix caps [skip ci]
    Schematic:
    - breakout pin headers J1, J11-J24 removed (never populated)
    - C40 47uF on +5V and C41 470uF on +3.3VA for the JDY-33 power-up issue
    - ERC 0 errors, no existing net changed, connector pins match spreadsheet
    PCB:
    - old Mini-Fit connectors, DC drivers, F3/F4, breakout headers and the
    routes that only led to them removed
    - board enlarged to 145 x 110 mm (right: EGT/M8, top: Superseal pin depth)
    - J30/J31, F11, M8, J32-J35, four MAX31855 groups, C40/C41 pre-placed
    - DRC: 0 errors except library courtyard of the Superseal footprint,
    schematic parity 0, 138 unconnected items left to route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
    [uaefi.kicad_pcb, uaefi.kicad_sch]
2026-09-23 uaefi-moto: parts sheet with connector part numbers in wiring spreadsheet [skip ci]
    [uaefi-moto-pinout.xlsx]
